jojae38/stepper_motor_controller/1.hardware/motor_42/motor_42.kicad_pcb

## KiCad design 1.hardware/motor_42/motor_42.kicad_pcb (2025-12-02)

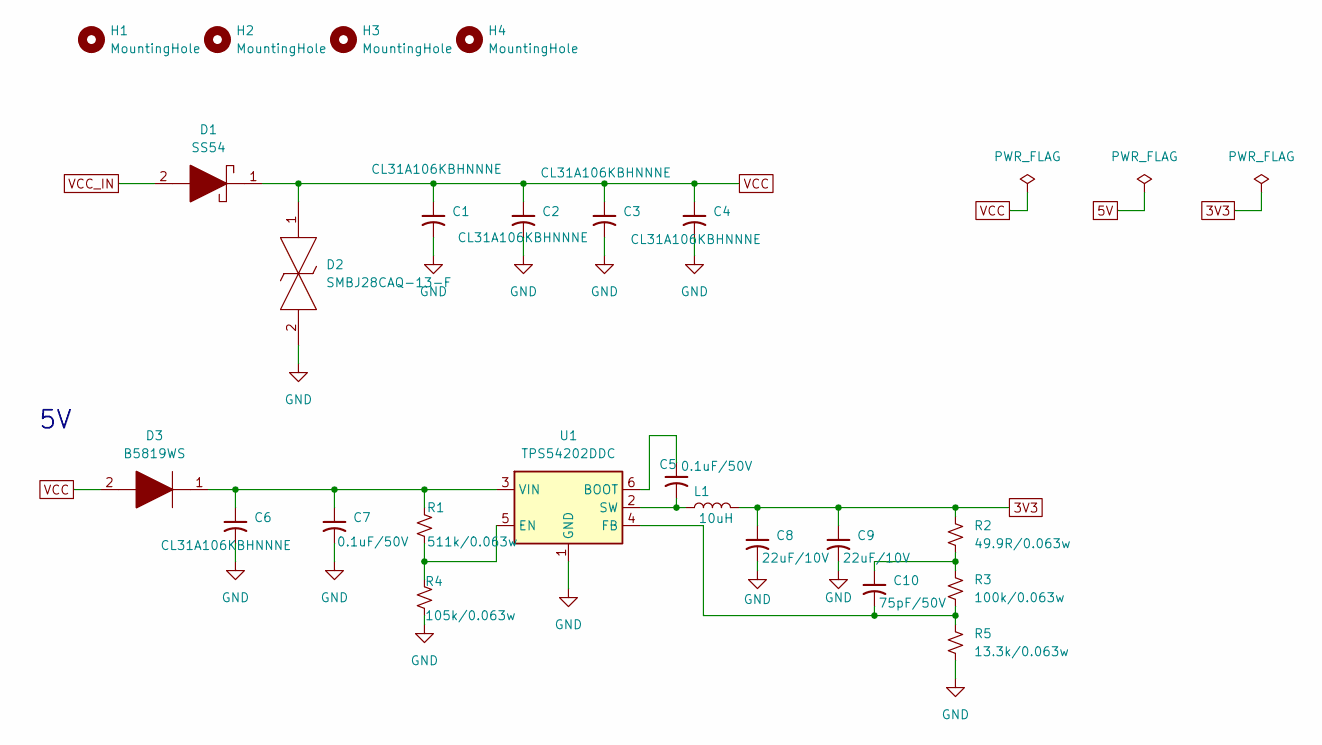
[picture p1: schematic Power.kicad_sch]

Parts:
C1, C2, C3, C4, C6: CL31A106KBHNNNE; C_1206_3216Metric
C5, C7: 0.1uF/50V; C_0402_1005Metric
C8, C9: 22uF/10V; C_1206_3216Metric
C10: 75pF/50V; C_0402_1005Metric
D1: SS54; DIOM5126X245N; Manufacturer_Part_Number SS54
D2: SMBJ28CAQ-13-F; DIONM5336X250N; Manufacturer_Part_Number SMBJ28CAQ-13-F; Mouser Part Number 621-SMBJ28CAQ-13-F
D3: B5819WS; D_SOD-323; Manufacturer_Part_Number B5819WS
H1, H2, H3, H4: MountingHole; MountingHole_3.2mm_M3
L1: 10uH; L_Sunlord_SWPA4020S
R1: 511k/0.063w; R_0402_1005Metric
R2: 49.9R/0.063w; R_0402_1005Metric
R3: 100k/0.063w; R_0402_1005Metric
R4: 105k/0.063w; R_0402_1005Metric
R5: 13.3k/0.063w; R_0402_1005Metric
U1: TPS54202DDC; SOT-23-6

Connections:
3V3: C8.1, C9.1, L1.2, R2.1; also elsewhere on the board
GND: C1.2, C2.2, C3.2, C4.2, C6.2, C7.2, C8.2, C9.2, D2.2, R4.2, R5.2, U1.1 (GND); also elsewhere on the board
unnamed: C10.1, R2.2, R3.1
unnamed: C5.1, U1.6 (BOOT)
unnamed: R1.2, R4.1, U1.5 (EN)
unnamed: C10.2, R3.2, R5.1, U1.4 (FB)
unnamed: C5.2, L1.1, U1.2 (SW)
unnamed: C6.1, C7.1, D3.1, R1.1, U1.3 (VIN)
VCC: C1.1, C2.1, C3.1, C4.1, D1.1, D2.1, D3.2; also elsewhere on the board
VCC_IN: D1.2; also elsewhere on the board

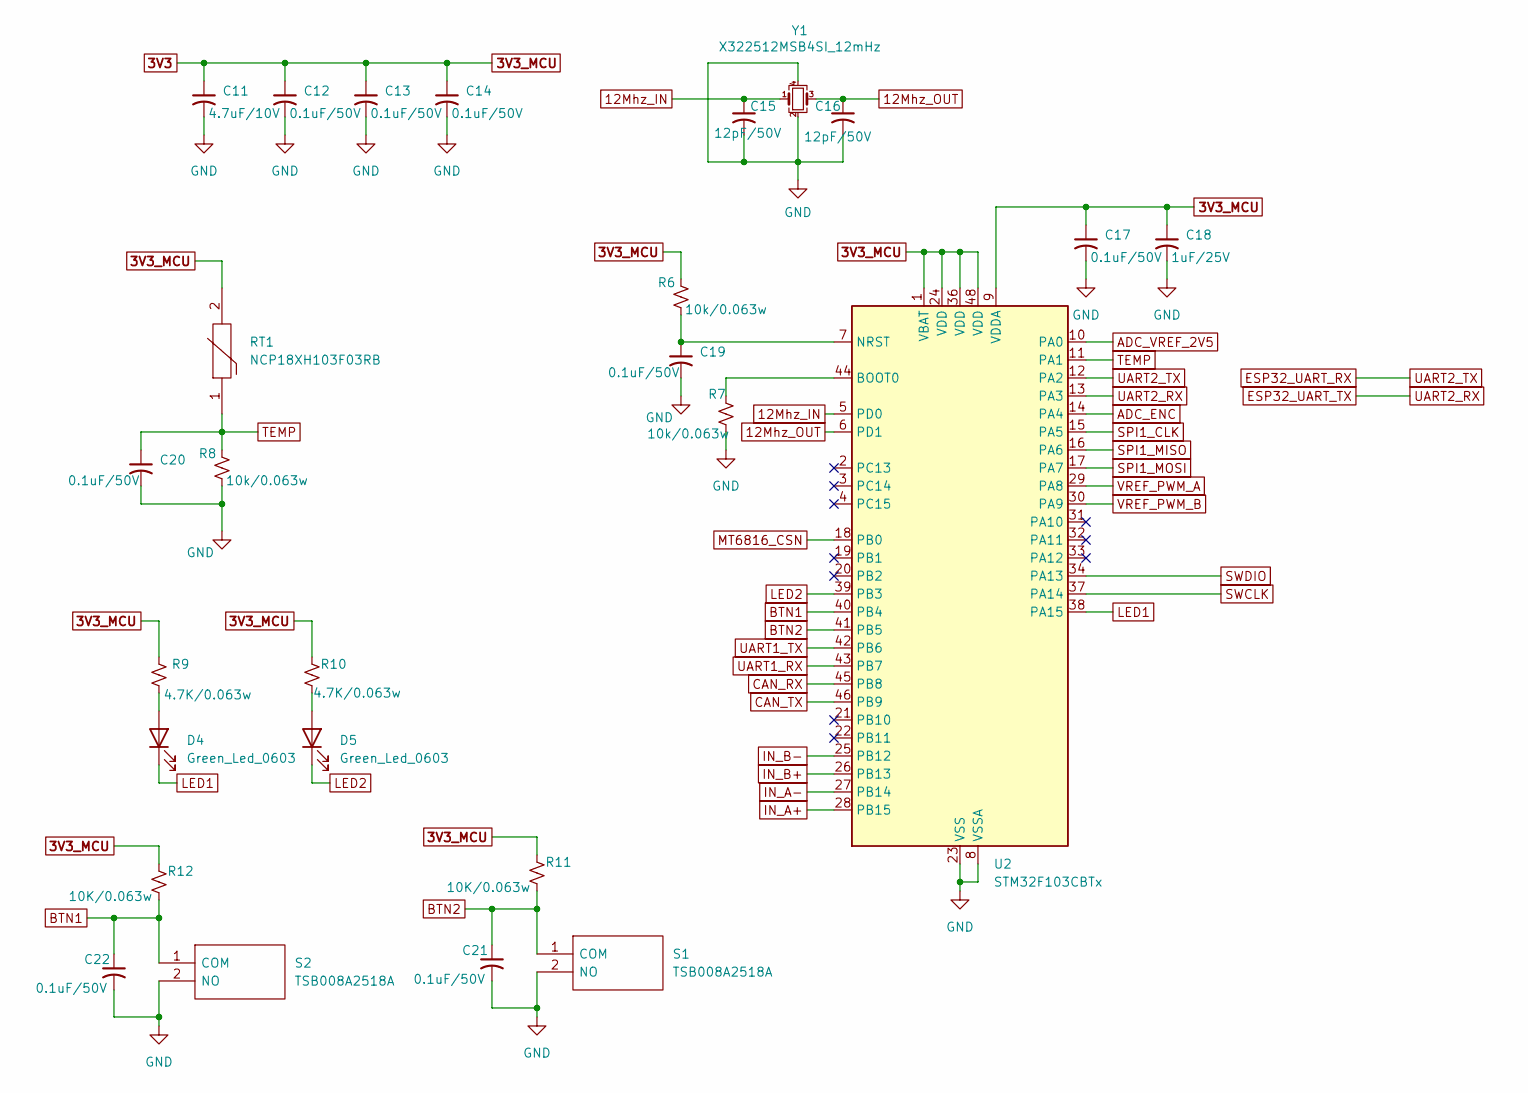
[picture p2: schematic Mcu.kicad_sch]

Parts:
C11: 4.7uF/10V; C_0603_1608Metric
C12, C13, C14, C17, C19, C20, C21, C22: 0.1uF/50V; C_0402_1005Metric
C15, C16: 12pF/50V; C_0402_1005Metric
C18: 1uF/25V; C_0402_1005Metric
D4, D5: Green_Led_0603; LED_0603_1608Metric
R6, R7, R8: 10k/0.063w; R_0402_1005Metric
R9, R10: 4.7K/0.063w; R_0402_1005Metric
R11, R12: 10K/0.063w; R_0402_1005Metric
RT1: NCP18XH103F03RB; THRMC1608X95N; Manufacturer_Part_Number NCP18XH103F03RB; Mouser Part Number 81-NCP18XH103F03RB
S1, S2: TSB008A2518A; Manufacturer_Part_Number TSB008A2518A
U2: STM32F103CBTx; LQFP-48_7x7mm_P0.5mm
Y1: X322512MSB4SI_12mHz; Crystal_SMD_3225-4Pin_3.2x2.5mm

Connections:
3V3: C11.1, C12.1, C13.1, C14.1, C17.1, C18.1, R6.2, R9.1, R10.1, R11.1, R12.1, RT1.2, U2.1 (VBAT), U2.9 (VDDA), U2.24 (VDD), U2.36 (VDD), U2.48 (VDD); also elsewhere on the board
12Mhz_IN: C15.1, U2.5 (PD0), Y1.1
12Mhz_OUT: C16.1, U2.6 (PD1), Y1.3
ADC_ENC: U2.14 (PA4); also elsewhere on the board
ADC_VREF_2V5: U2.10 (PA0); also elsewhere on the board
BTN1: C22.1, R12.2, S2.1 (COM), U2.40 (PB4)
BTN2: C21.1, R11.2, S1.1 (COM), U2.41 (PB5)
CAN_RX: U2.45 (PB8); also elsewhere on the board
CAN_TX: U2.46 (PB9); also elsewhere on the board
ESP32_UART_RX: U2.12 (PA2); also elsewhere on the board
ESP32_UART_TX: U2.13 (PA3); also elsewhere on the board
GND: C11.2, C12.2, C13.2, C14.2, C15.2, C16.2, C17.2, C18.2, C19.2, C20.2, C21.2, C22.2, R7.2, R8.1, S1.2 (NO), S2.2 (NO), U2.8 (VSSA), U2.23 (VSS), U2.35 (VSS), U2.47 (VSS), Y1.2, Y1.4; also elsewhere on the board
IN_A+: U2.28 (PB15); also elsewhere on the board
IN_A-: U2.27 (PB14); also elsewhere on the board
IN_B+: U2.26 (PB13); also elsewhere on the board
IN_B-: U2.25 (PB12); also elsewhere on the board
LED1: D4.1 (K), U2.38 (PA15)
LED2: D5.1 (K), U2.39 (PB3)
MT6816_CSN: U2.18 (PB0); also elsewhere on the board
unnamed: D4.2 (A), R9.2
unnamed: D5.2 (A), R10.2
unnamed: R7.1, U2.44 (BOOT0)
unnamed: C19.1, R6.1, U2.7 (NRST)
SPI1_CLK: U2.15 (PA5); also elsewhere on the board
SPI1_MISO: U2.16 (PA6); also elsewhere on the board
SPI1_MOSI: U2.17 (PA7); also elsewhere on the board
SWCLK: U2.37 (PA14); also elsewhere on the board
SWDIO: U2.34 (PA13); also elsewhere on the board
TEMP: C20.1, R8.2, RT1.1, U2.11 (PA1)
UART1_RX: U2.43 (PB7); also elsewhere on the board
UART1_TX: U2.42 (PB6); also elsewhere on the board
VREF_PWM_A: U2.29 (PA8); also elsewhere on the board
VREF_PWM_B: U2.30 (PA9); also elsewhere on the board

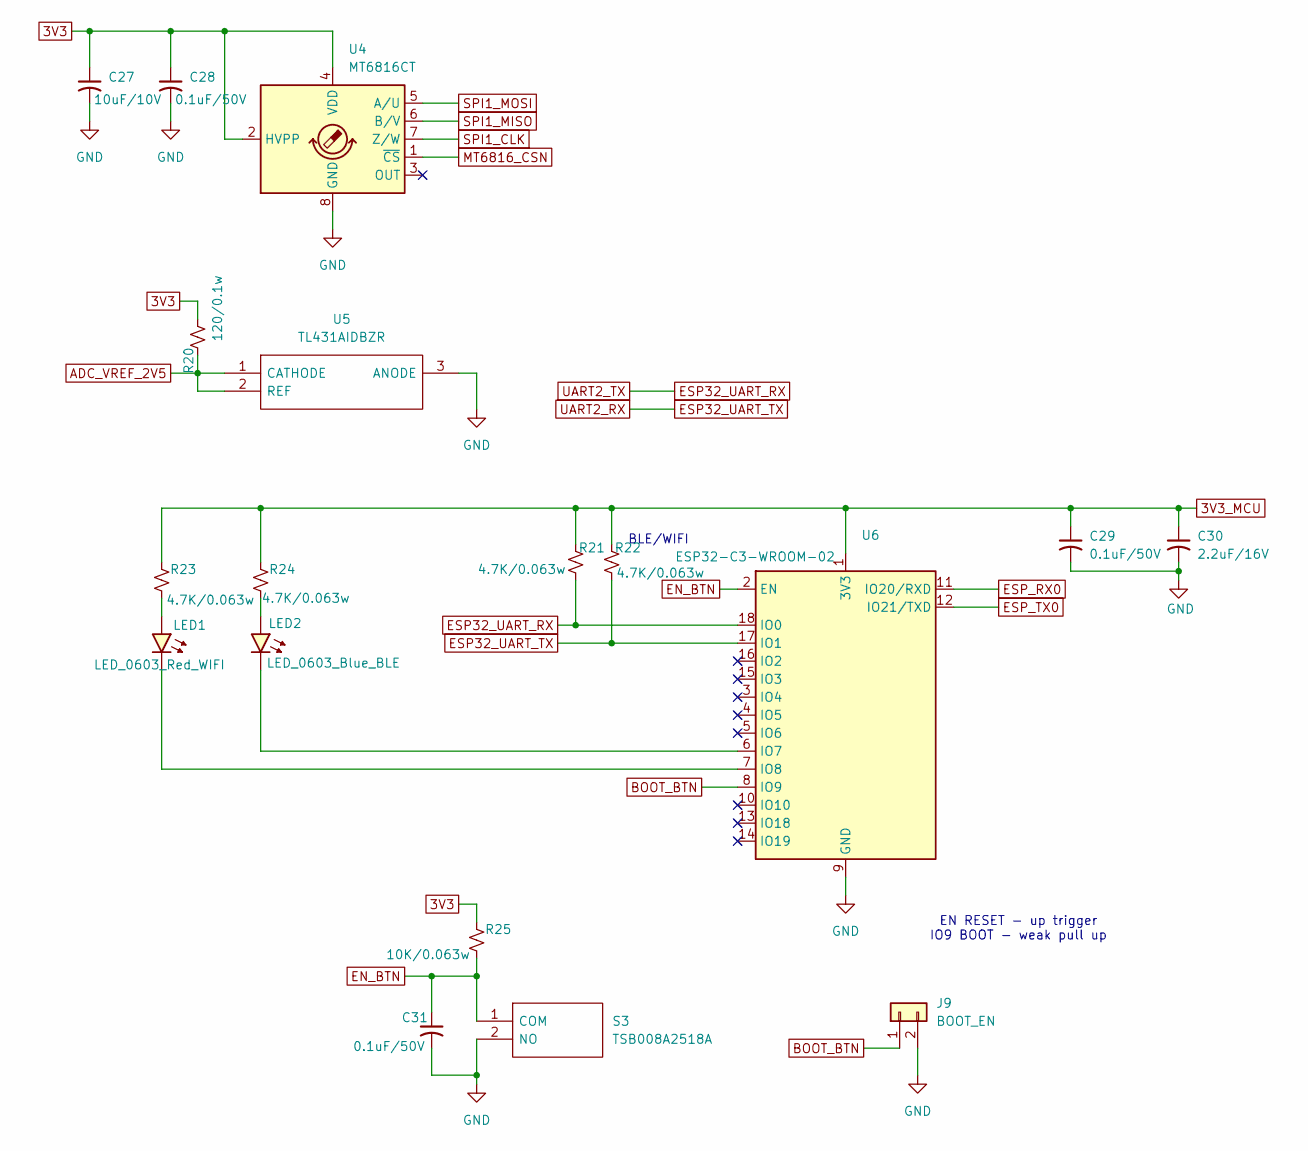
[picture p3: schematic Interface.kicad_sch]

Parts:
C27: 10uF/10V; C_0603_1608Metric
C28, C29, C31: 0.1uF/50V; C_0402_1005Metric
C30: 2.2uF/16V; C_0603_1608Metric
J9: BOOT_EN; PinHeader_1x02_P2.54mm_Vertical
LED1: LED_0603_Red_WIFI; LED_0603_1608Metric
LED2: LED_0603_Blue_BLE; LED_0603_1608Metric
R20: 120/0.1w; R_0603_1608Metric
R21, R22, R23, R24: 4.7K/0.063w; R_0402_1005Metric
R25: 10K/0.063w; R_0402_1005Metric
S3: TSB008A2518A; Manufacturer_Part_Number TSB008A2518A
U4: MT6816CT; SO-8_3.9x4.9mm_P1.27mm
U5: TL431AIDBZR; SOT95P237X112-3N; Manufacturer_Part_Number TL431AIDBZR; Mouser Part Number 595-TL431AIDBZR
U6: ESP32-C3-WROOM-02

Connections:
3V3: C27.1, C28.1, C29.1, C30.1, R20.1, R21.1, R22.1, R23.1, R24.1, R25.1, U4.2 (HVPP), U4.4 (VDD), U6.1 (3V3); also elsewhere on the board
ADC_VREF_2V5: R20.2, U5.1 (CATHODE), U5.2 (REF); also elsewhere on the board
BOOT_BTN: J9.1, U6.8 (IO9)
EN_BTN: C31.1, R25.2, S3.1 (COM), U6.2 (EN)
ESP32_UART_RX: R21.2, U6.18 (IO0); also elsewhere on the board
ESP32_UART_TX: R22.2, U6.17 (IO1); also elsewhere on the board
ESP_RX0: U6.11 (IO20/RXD); also elsewhere on the board
ESP_TX0: U6.12 (IO21/TXD); also elsewhere on the board
GND: C27.2, C28.2, C29.2, C30.2, C31.2, J9.2, S3.2 (NO), U4.8 (GND), U5.3 (ANODE), U6.9 (GND), U6.19 (GND); also elsewhere on the board
MT6816_CSN: U4.1 (~CS); also elsewhere on the board
unnamed: LED1.2 (A), R23.2
unnamed: LED1.1 (K), U6.7 (IO8)
unnamed: LED2.2 (A), R24.2
unnamed: LED2.1 (K), U6.6 (IO7)
SPI1_CLK: U4.7 (Z/W); also elsewhere on the board
SPI1_MISO: U4.6 (B/V); also elsewhere on the board
SPI1_MOSI: U4.5 (A/U); also elsewhere on the board

Notes on the sheet:
BLE/WIFI
EN RESET - up trigger IO9 BOOT - weak pull up

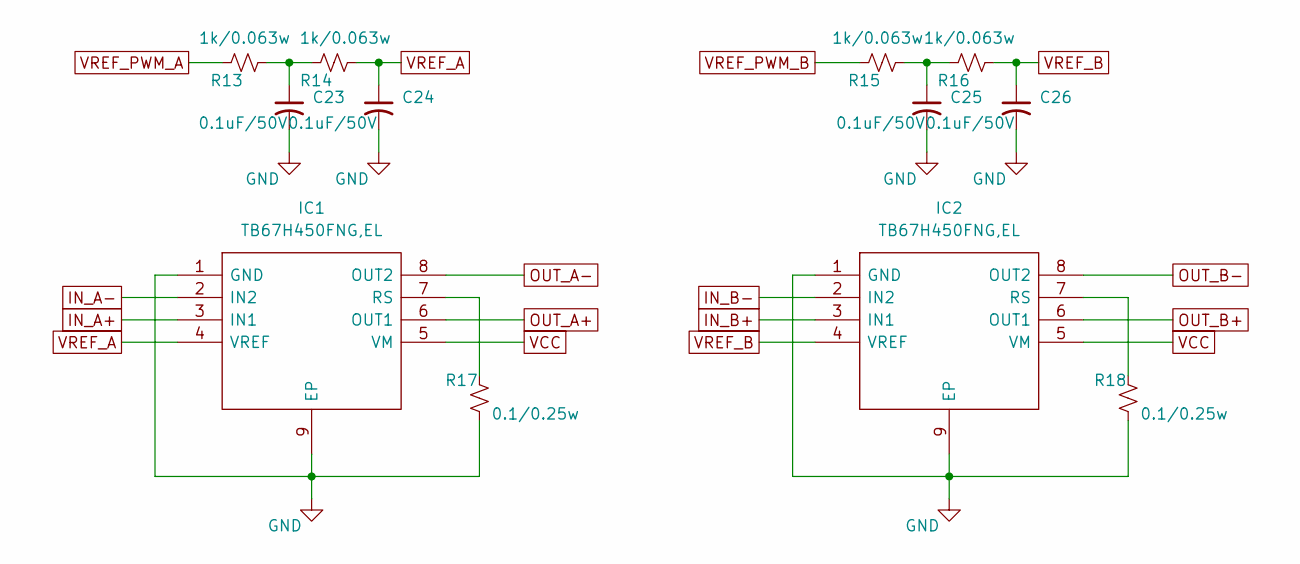
[picture p4: schematic Driver.kicad_sch]

Parts:
C23, C24, C25, C26: 0.1uF/50V; C_0402_1005Metric
IC1, IC2: TB67H450FNG,EL; SOIC127P600X175-9N; Manufacturer_Part_Number TB67H450FNG,EL; Mouser Part Number 757-TB67H450FNGEL
R13, R14, R15, R16: 1k/0.063w; R_0402_1005Metric
R17, R18: 0.1/0.25w; R_1206_3216Metric

Connections:
GND: C23.2, C24.2, C25.2, C26.2, IC1.1 (GND), IC1.9 (EP), IC2.1 (GND), IC2.9 (EP), R17.1, R18.1; also elsewhere on the board
IN_A+: IC1.3 (IN1); also elsewhere on the board
IN_A-: IC1.2 (IN2); also elsewhere on the board
IN_B+: IC2.3 (IN1); also elsewhere on the board
IN_B-: IC2.2 (IN2); also elsewhere on the board
unnamed: C23.1, R13.1, R14.2
unnamed: C25.1, R15.1, R16.2
unnamed: IC1.7 (RS), R17.2
unnamed: IC2.7 (RS), R18.2
OUT_A+: IC1.6 (OUT1); also elsewhere on the board
OUT_A-: IC1.8 (OUT2); also elsewhere on the board
OUT_B+: IC2.6 (OUT1); also elsewhere on the board
OUT_B-: IC2.8 (OUT2); also elsewhere on the board
VCC: IC1.5 (VM), IC2.5 (VM); also elsewhere on the board
VREF_A: C24.1, IC1.4 (VREF), R14.1
VREF_B: C26.1, IC2.4 (VREF), R16.1
VREF_PWM_A: R13.2; also elsewhere on the board
VREF_PWM_B: R15.2; also elsewhere on the board

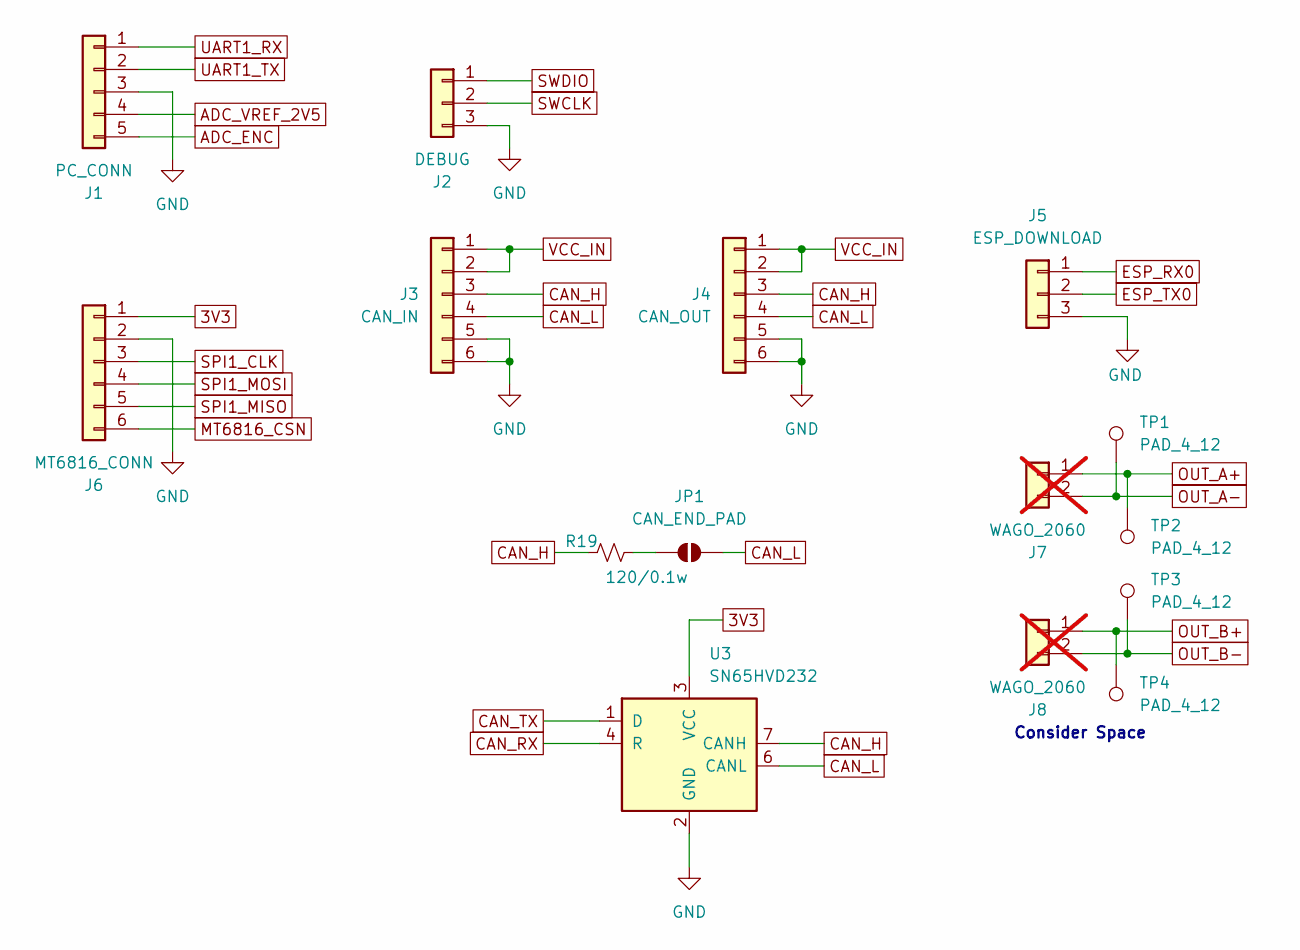
[picture p5: schematic Port.kicad_sch]

Parts:
J1: PC_CONN; JST_SH_SM05B-SRSS-TB_1x05-1MP_P1.00mm_Horizontal
J2: DEBUG; JST_SH_SM03B-SRSS-TB_1x03-1MP_P1.00mm_Horizontal
J3: CAN_IN; JST_SH_SM06B-SRSS-TB_1x06-1MP_P1.00mm_Horizontal
J4: CAN_OUT; JST_SH_SM06B-SRSS-TB_1x06-1MP_P1.00mm_Horizontal
J5: ESP_DOWNLOAD; JST_SH_SM03B-SRSS-TB_1x03-1MP_P1.00mm_Horizontal
J6: MT6816_CONN; JST_SH_SM05B-SRSS-TB_1x05-1MP_P1.00mm_Horizontal
J7, J8: WAGO_2060; not fitted
JP1: CAN_END_PAD; SolderJumper-2_P1.3mm_Open_RoundedPad1.0x1.5mm
R19: 120/0.1w; R_0603_1608Metric
TP1, TP2, TP3, TP4: PAD_4_12; custom_pad_2_5
U3: SN65HVD232; SOIC-8_3.9x4.9mm_P1.27mm

Connections:
3V3: J6.1, U3.3 (VCC); also elsewhere on the board
ADC_ENC: J1.5; also elsewhere on the board
ADC_VREF_2V5: J1.4; also elsewhere on the board
CAN_H: J3.3, J4.3, R19.2, U3.7 (CANH)
CAN_L: J3.4, J4.4, JP1.2 (B), U3.6 (CANL)
CAN_RX: U3.4 (R); also elsewhere on the board
CAN_TX: U3.1 (D); also elsewhere on the board
ESP_RX0: J5.1; also elsewhere on the board
ESP_TX0: J5.2; also elsewhere on the board
GND: J1.3, J2.3, J3.5, J3.6, J4.5, J4.6, J5.3, J6.2, U3.2 (GND); also elsewhere on the board
unnamed: JP1.1 (A), R19.1
OUT_A+: J7.1, TP2.1; also elsewhere on the board
OUT_A-: J7.2, TP1.1; also elsewhere on the board
OUT_B+: J8.1, TP4.1; also elsewhere on the board
OUT_B-: J8.2, TP3.1; also elsewhere on the board
SPI1_CLK: J6.3; also elsewhere on the board
SPI1_MISO: J6.5; also elsewhere on the board
SPI1_MOSI: J6.4; also elsewhere on the board
SWCLK: J2.2; also elsewhere on the board
SWDIO: J2.1; also elsewhere on the board
UART1_RX: J1.1; also elsewhere on the board
UART1_TX: J1.2; also elsewhere on the board
VCC_IN: J3.1, J3.2, J4.1, J4.2; also elsewhere on the board

Notes on the sheet:
Consider Space

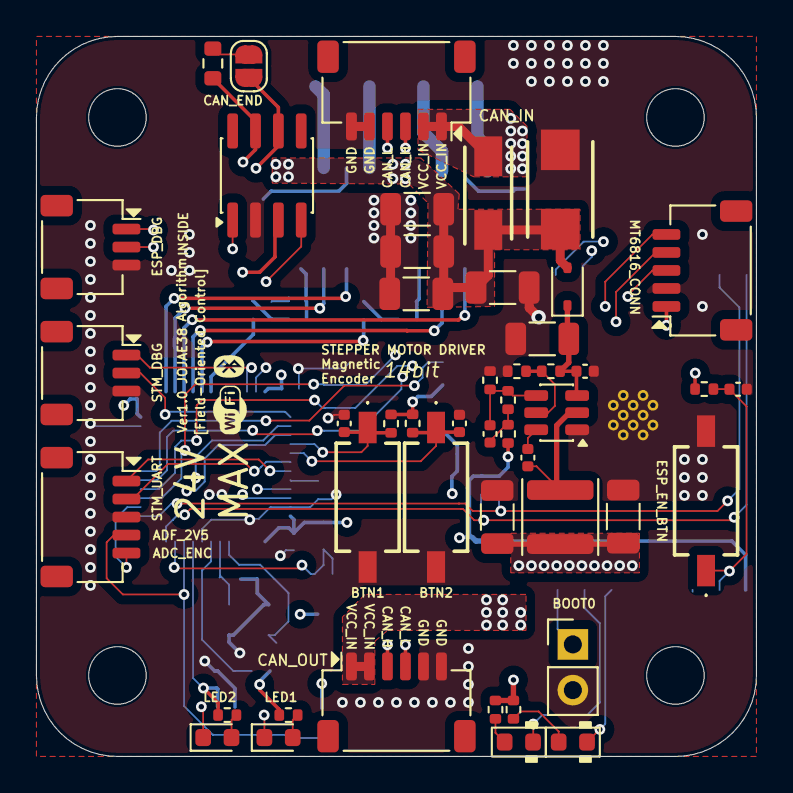
[picture p6: board motor_42.kicad_pcb from above]

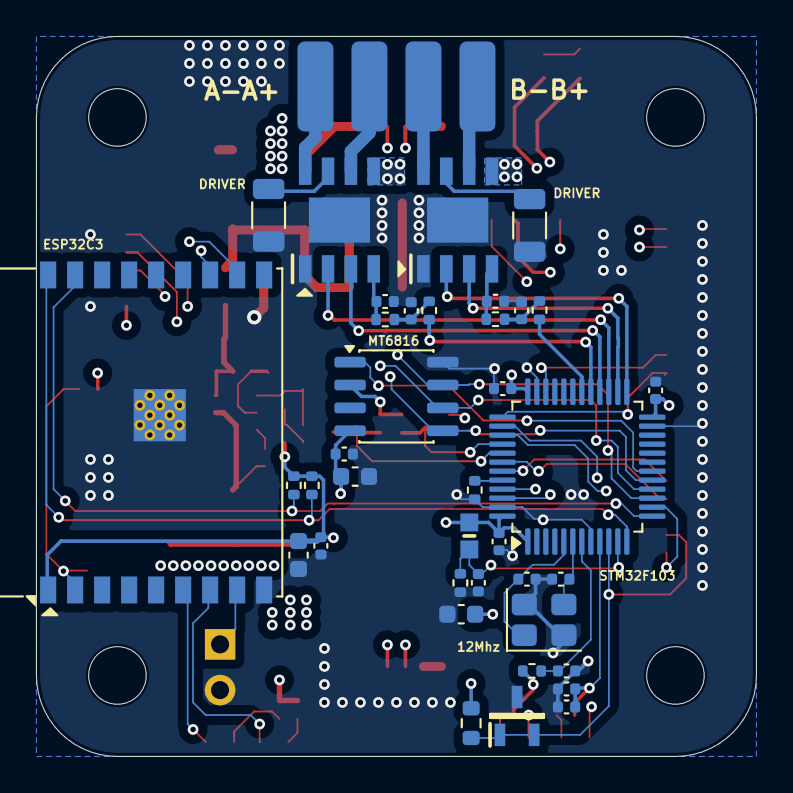
[picture p7: board motor_42.kicad_pcb from below]

Board: 4 copper layers, 40.0 x 40.0 mm, 93 parts (42 on the bottom side), 62 nets.
