jojae38/stepper_motor_controller/2.firmware/step_motor_controller/step_motor_controller.ioc

Mcu.UserName=STM32F103CBTx
PA0-WKUP.GPIO_Label=ADC1_0_VREF_2V5
PA0-WKUP.Signal=ADCx_IN0
PA1.GPIO_Label=ADC1_1_TEMP
PA1.Signal=ADCx_IN1
PA11.GPIO_Label=NC_USB_DM
PA11.Signal=USB_DM
PA12.GPIO_Label=NC_USB_DP
PA12.Signal=USB_DP
PA13.Signal=SYS_JTMS-SWDIO
PA14.Signal=SYS_JTCK-SWCLK
PA15.GPIO_Label=LED1
PA15.Signal=GPIO_Output
PA2.GPIO_Label=UART2_TX_ESP32
PA2.Signal=USART2_TX
PA3.GPIO_Label=UART2_RX_ESP32
PA3.Signal=USART2_RX
PA4.GPIO_Label=ADC_ENC
PA4.Signal=GPIO_Output
PA5.Signal=SPI1_SCK
PA6.Signal=SPI1_MISO
PA7.Signal=SPI1_MOSI
PA8.GPIO_Label=VREF_PWM_A
PA8.Signal=S_TIM1_CH1
PA9.GPIO_Label=VREF_PWM_B
PA9.Signal=S_TIM1_CH2
PB0.GPIO_Label=MT6816_CSN
PB0.Signal=GPIO_Output
PB12.GPIO_Label=IN_B_M
PB12.Signal=GPIO_Output
PB13.GPIO_Label=IN_B_P
PB13.Signal=GPIO_Output
PB14.GPIO_Label=IN_A_M
PB14.Signal=GPIO_Output
PB15.GPIO_Label=IN_A_P
PB15.Signal=GPIO_Output
PB3.GPIO_Label=LED2
PB3.Signal=GPIO_Output
PB4.GPIO_Label=BTN1
PB4.Signal=GPIO_Input
PB5.GPIO_Label=BTN2
PB5.Signal=GPIO_Input
PB6.Signal=USART1_TX
PB7.Signal=USART1_RX
PB8.Signal=CAN_RX
PB9.Signal=CAN_TX
PD0-OSC_IN.Signal=RCC_OSC_IN
PD1-OSC_OUT.Signal=RCC_OSC_OUT
