jojae38/stepper_motor_controller/2.firmware/step_motor_controller/Service/motor_control.h

/*
 * motor_control.h
 *
 *  Created on: 2026. 1. 8.
 *      Author: jojae
 */

#ifndef MOTOR_CONTROL_H_
#define MOTOR_CONTROL_H_

#include "hw_def.h"

typedef struct{


}step_motor_tbl_t;

void motorInit(void);
void motorMain(void);
float getMotorAngle(void);
float getMotorDegree(void);
void  printMotorDegree(void);

#endif /* MOTOR_CONTROL_H_ */
