jojae38/stepper_motor_controller/2.firmware/step_motor_controller/Core/Inc/main.h

#define ADC1_0_VREF_2V5_Pin GPIO_PIN_0
#define ADC1_0_VREF_2V5_GPIO_Port GPIOA
#define ADC1_1_TEMP_Pin GPIO_PIN_1
#define ADC1_1_TEMP_GPIO_Port GPIOA
#define UART2_TX_ESP32_Pin GPIO_PIN_2
#define UART2_TX_ESP32_GPIO_Port GPIOA
#define UART2_RX_ESP32_Pin GPIO_PIN_3
#define UART2_RX_ESP32_GPIO_Port GPIOA
#define ADC_ENC_Pin GPIO_PIN_4
#define ADC_ENC_GPIO_Port GPIOA
#define MT6816_CSN_Pin GPIO_PIN_0
#define MT6816_CSN_GPIO_Port GPIOB
#define IN_B_M_Pin GPIO_PIN_12
#define IN_B_M_GPIO_Port GPIOB
#define IN_B_P_Pin GPIO_PIN_13
#define IN_B_P_GPIO_Port GPIOB
#define IN_A_M_Pin GPIO_PIN_14
#define IN_A_M_GPIO_Port GPIOB
#define IN_A_P_Pin GPIO_PIN_15
#define IN_A_P_GPIO_Port GPIOB
#define VREF_PWM_A_Pin GPIO_PIN_8
#define VREF_PWM_A_GPIO_Port GPIOA
#define VREF_PWM_B_Pin GPIO_PIN_9
#define VREF_PWM_B_GPIO_Port GPIOA
#define NC_USB_DM_Pin GPIO_PIN_11
#define NC_USB_DM_GPIO_Port GPIOA
#define NC_USB_DP_Pin GPIO_PIN_12
#define NC_USB_DP_GPIO_Port GPIOA
#define LED1_Pin GPIO_PIN_15
#define LED1_GPIO_Port GPIOA
#define LED2_Pin GPIO_PIN_3
#define LED2_GPIO_Port GPIOB
#define BTN1_Pin GPIO_PIN_4
#define BTN1_GPIO_Port GPIOB
#define BTN2_Pin GPIO_PIN_5
#define BTN2_GPIO_Port GPIOB
