jojae38/stepper_motor_controller/2.firmware/step_motor_controller/Service/motor_control.c

/*
 * motor_control.c
 *
 *  Created on: 2026. 1. 8.
 *      Author: jojae
 */


#include "motor_control.h"




void motorInit(void)
{
  //모터의 제로 포인트로 이동
}

void motorMain(void)
{

}

float getMotorAngle(void)
{
  float ret = 0;
  return ret;
}

float getMotorDegree(void)
{
  float ret = 0;
  return ret;
}

void  printMotorDegree(void)
{

}
