jojae38/stepper_motor_controller/2.firmware/step_motor_controller/Service/esp32_cli.h

/*
 * esp32_cli.h
 *
 *  Created on: 2026. 1. 4.
 *      Author: jaehyun
 */

#ifndef ESP32_CLI_H_
#define ESP32_CLI_H_

#include "hw_def.h"

void esp32CliInit(void);
void esp32CliMain(void);

#endif /* ESP32_CLI_H_ */
