jojae38/stepper_motor_controller/(commit log)

2025-11-18 중간 저장
    [Driver.kicad_sch, Interface.kicad_sch, Mcu.kicad_sch, Port.kicad_sch, Power.kicad_sch, motor_42.kicad_pcb, motor_42.kicad_sch]
2025-11-26 살짝 변경
    [Port.kicad_sch]
2025-11-27 작은 변경
    [motor_42.kicad_pcb]
2025-11-29 회로도 대충 완성
    [Driver.kicad_sch, Interface.kicad_sch, Mcu.kicad_sch, Port.kicad_sch, Power.kicad_sch, motor_42.kicad_pcb, motor_42.kicad_sch]
2025-11-30 3V3 LDO변경 및 대략적 위치 세팅
    [Interface.kicad_sch, Mcu.kicad_sch, Port.kicad_sch, Power.kicad_sch, motor_42.kicad_pcb]
2025-12-01 얼추 다 그림
    [Interface.kicad_sch, Mcu.kicad_sch, Port.kicad_sch, Power.kicad_sch, motor_42.kicad_pcb]
2025-12-01 실크 업데이트
    [motor_42.kicad_pcb]
2025-12-01 비아 변경 필요
    [Interface.kicad_sch, Mcu.kicad_sch, bom.csv, designators.csv, motor_42.kicad_pcb, positions.csv]
2025-12-02 via 홀 0.3 직경 0.6(1.5의 폭 을 가진다) 수정 및 라우팅 개선
    [motor_42.kicad_pcb]
2025-12-02 wifi ble 문양 추가
    [motor_42.kicad_pcb]
2025-12-02 번호 초기화 및 led 변경
    [Driver.kicad_sch, Interface.kicad_sch, Mcu.kicad_sch, Port.kicad_sch, Power.kicad_sch, bom.csv, designators.csv, motor_42.kicad_pcb]
2025-12-04 생산파일
    [bom.csv, designators.csv, positions.csv]
2026-01-06 코드 추가
    [Power.kicad_sch]
2026-01-08 기본 코드 구조 생성
2026-01-08 중간 수정
2026-01-13 cli 기능 추가
2026-01-18 검증 및 수정
2026-01-19 CLI 항목 추가
