jojae38/stepper_motor_controller/(notices)

Notices in the files:
2.firmware/step_motor_controller/Core/Inc/main.h:
Copyright (c) 2025 STMicroelectronics.
All rights reserved.
This software is licensed under terms that can be found in the LICENSE file
